mills-builds/agent-vision/docs/images/buslinker.png

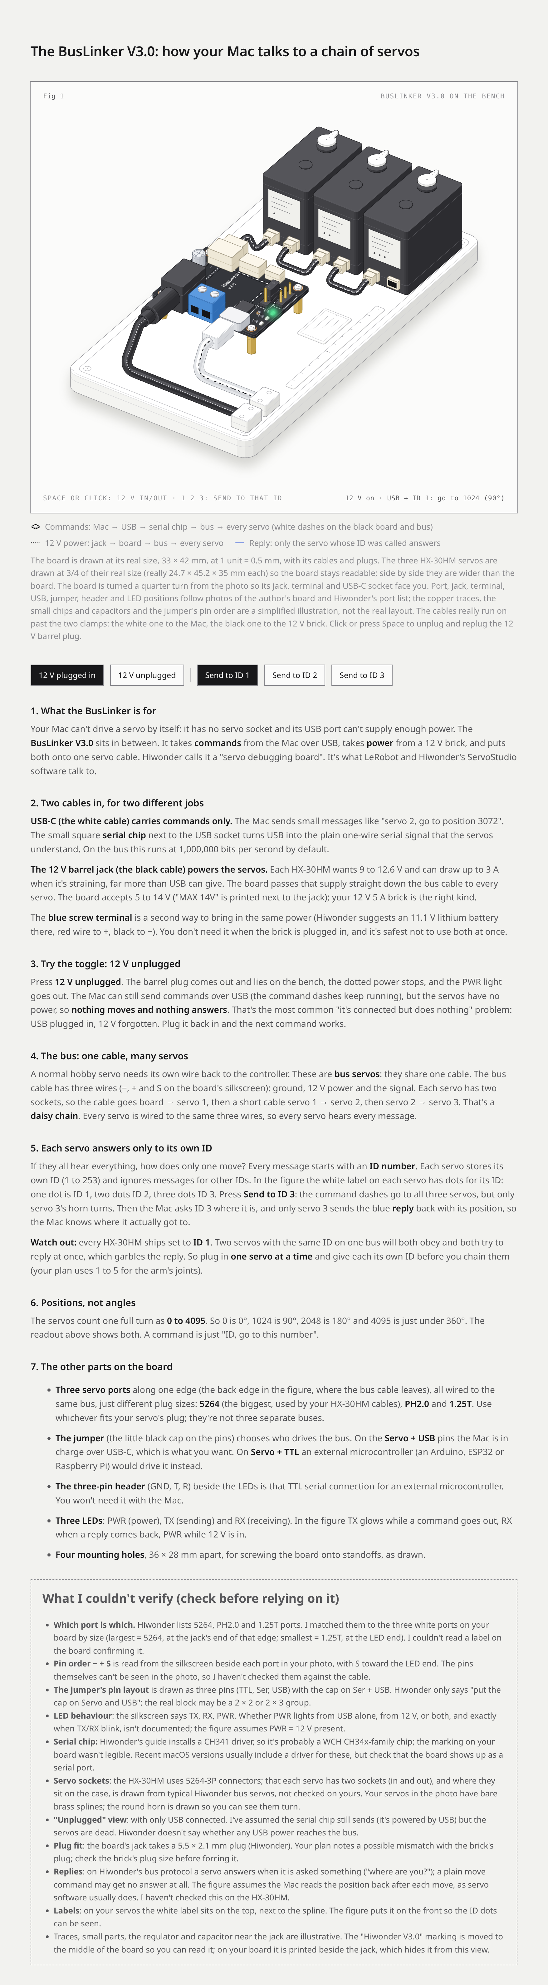
docs/images/buslinker.png
