mills-builds/agent-vision/docs/images/so101-camera-arm-dark.png

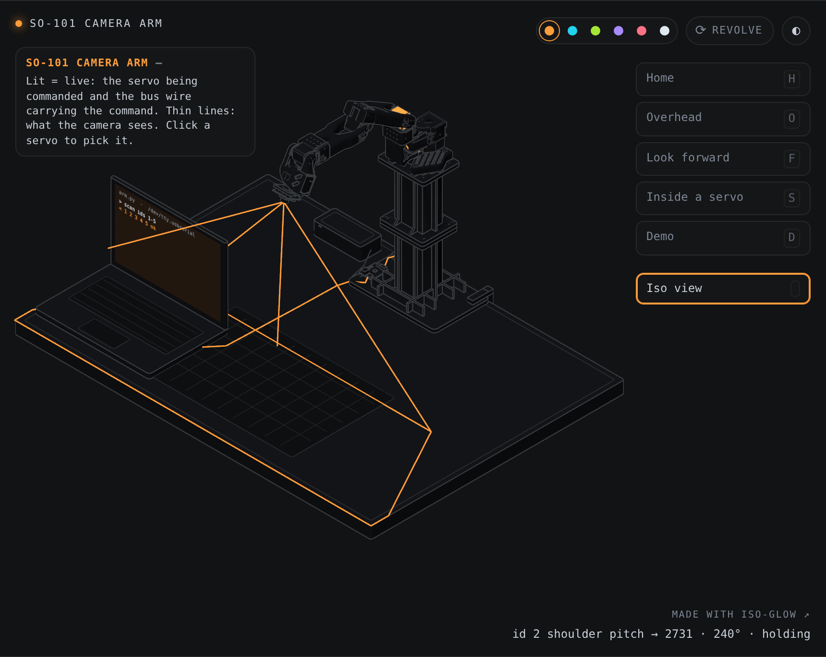
docs/images/so101-camera-arm-dark.png
