mills-builds/agent-vision/docs/images/so101-camera-arm-inside.png

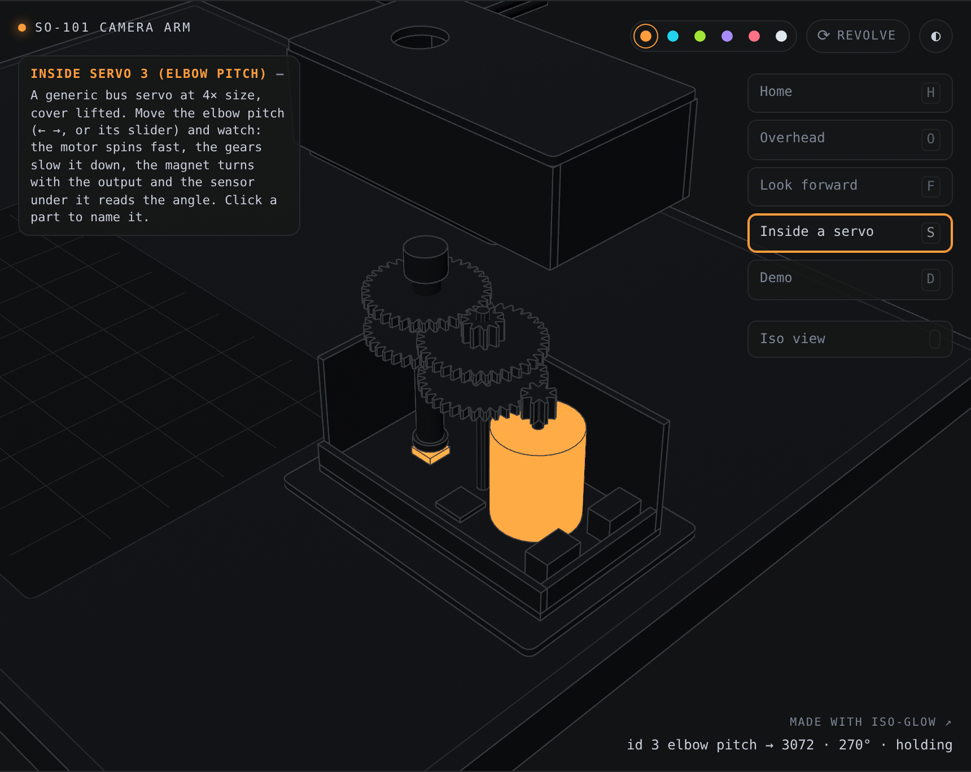
docs/images/so101-camera-arm-inside.png
