mills-builds/agent-vision/docs/images/so101-camera-arm-look.png

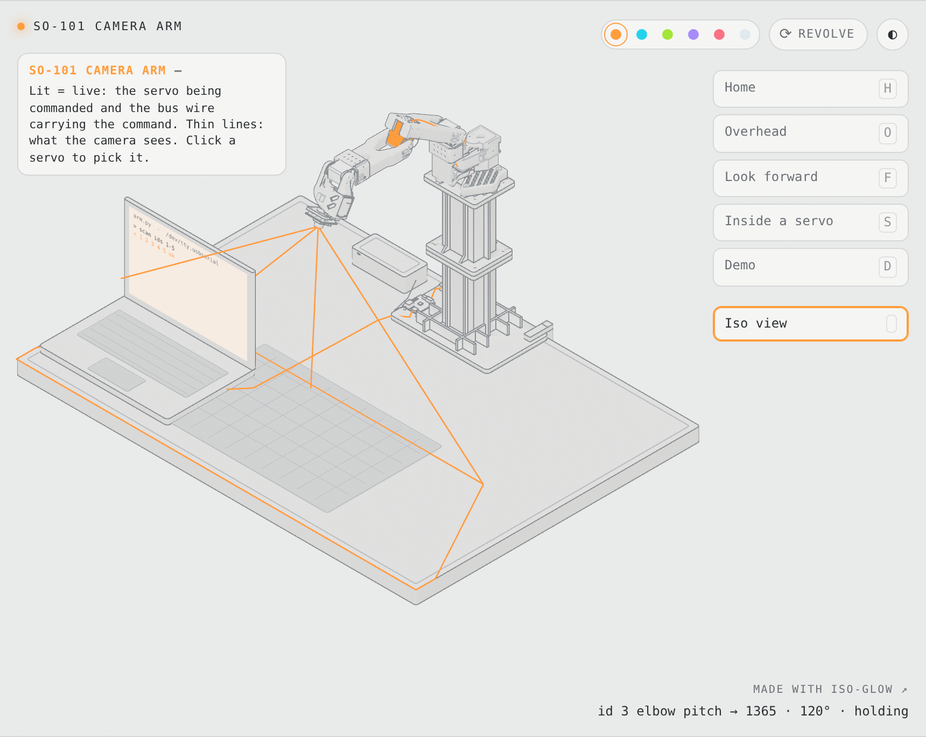
docs/images/so101-camera-arm-look.png
