mills-builds/agent-vision/cad/stl/arm_adapter_plate_v2_print-facedown.stl

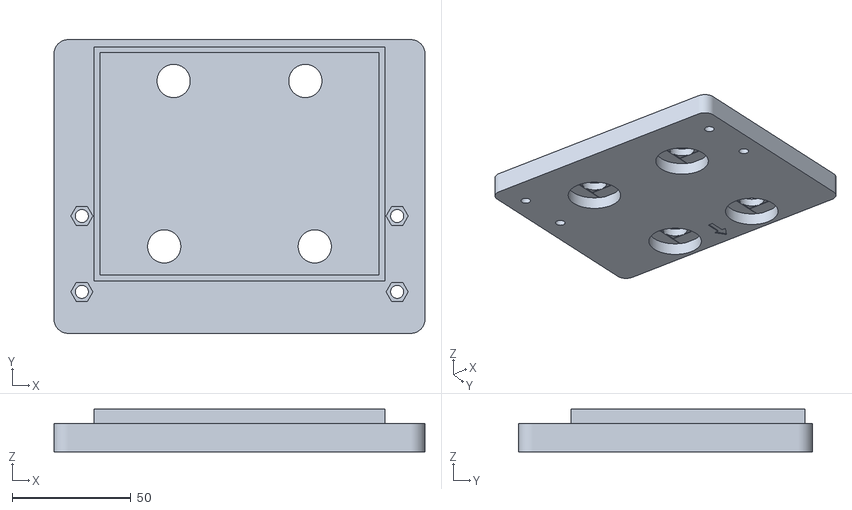
[picture p8: CAD file, 2026-10-14]
cad/stl/arm_adapter_plate_v2_print-facedown.stl
156.5 x 123.9 x 18.0
