mills-builds/agent-vision/cad/stl/arm_adapter_clamp_v2_left_print-facedown.stl

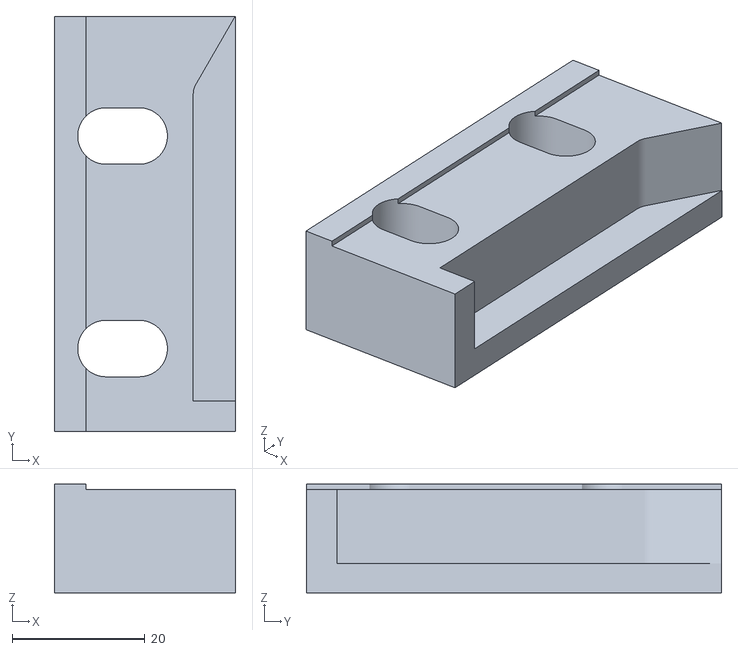
[picture p9: CAD file, 2026-10-14]
cad/stl/arm_adapter_clamp_v2_left_print-facedown.stl
27.2 x 62.5 x 16.4
