mills-builds/agent-vision/cad/stl/camera_plate_v3.stl

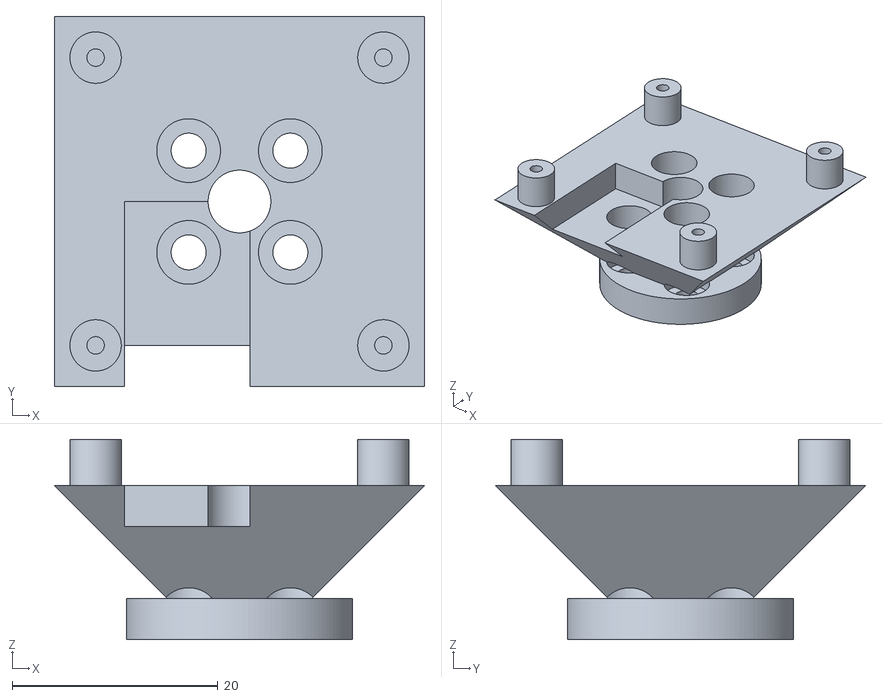
[picture p10: CAD file, 2026-10-14]
cad/stl/camera_plate_v3.stl
36.0 x 36.0 x 19.5
