mills-builds/agent-vision/cad/stl/riser_B_top_v2.stl

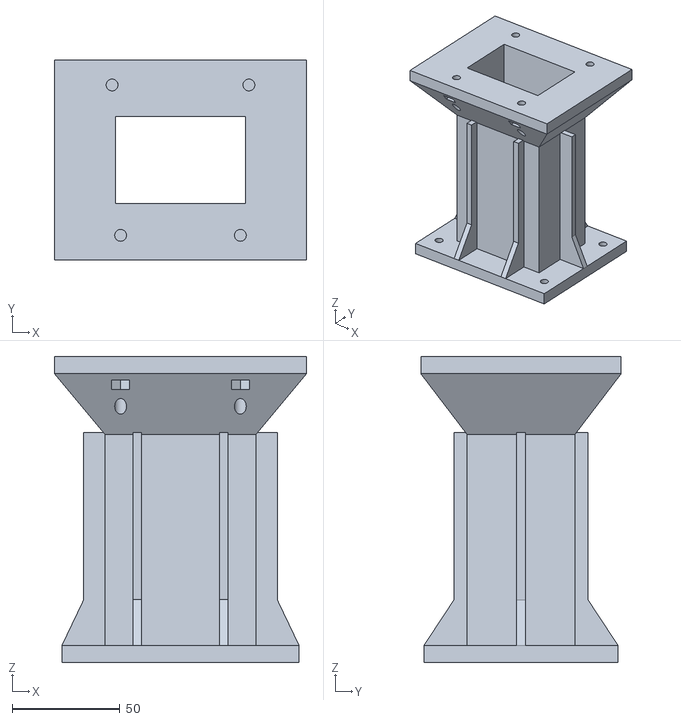
[picture p11: CAD file, 2026-10-14]
cad/stl/riser_B_top_v2.stl
117.0 x 93.0 x 142.0
