mills-builds/agent-vision/cad/stl/riser_A_foot_v2.stl

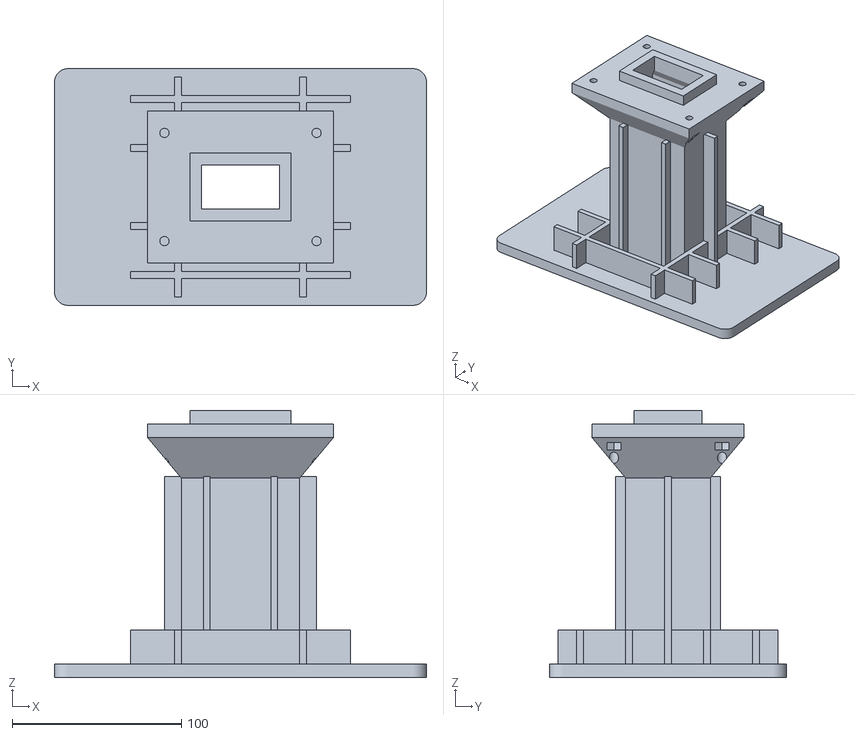
[picture p12: CAD file, 2026-10-14]
cad/stl/riser_A_foot_v2.stl
220.0 x 140.0 x 158.0
