mills-builds/agent-vision/cad/stl/buslinker_mount.stl

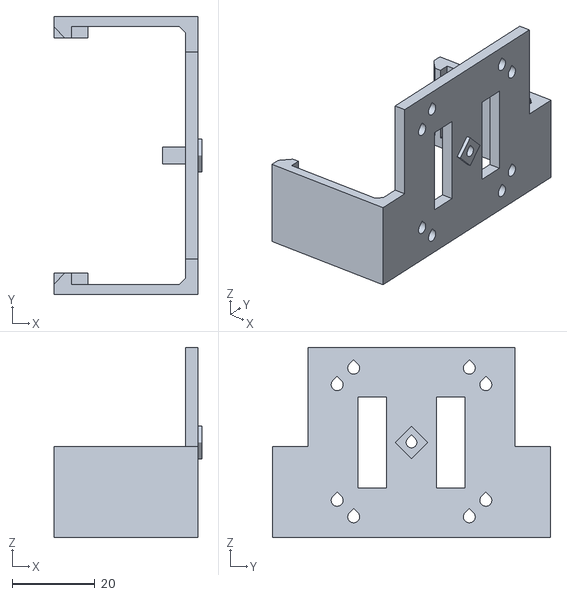
[picture p13: CAD file, 2026-10-14]
cad/stl/buslinker_mount.stl
35.8 x 67.4 x 46.0
