mills-builds/agent-vision/(list of files, cad)

Other CAD files:
cad/stl/arm_adapter_clamp_v2_right_print-facedown.stl
