mills-builds/agent-vision/(commit log)

2026-10-12 Agent Vision: riser and camera plate CAD, 3D explainers, credits
    [camera_plate.stl, riser_A_foot.stl, riser_B_top.stl]
2026-10-14 Move camera frames out of repo, ignore *.jpg, move assembly diagrams to docs/
2026-10-14 Add v2 arm adapter and BusLinker mount CAD sources
2026-10-14 Add agent_vision package: hx_bus driver and av_* tools with unit tests
2026-10-14 README: parts, assembly, wiring, setup, range discovery, presets, safety
2026-10-14 CAD: replace v1 riser/camera plate STLs with current v2 print files under cad/stl, add riser and camera plate sources
    [arm_adapter_clamp_v2_left_print-facedown.stl, arm_adapter_clamp_v2_right_print-facedown.stl, arm_adapter_plate_v2_print-facedown.stl, buslinker_mount.stl, camera_plate.stl, camera_plate_v3.stl, riser_A_foot.stl, riser_A_foot_v2.stl]
2026-10-14 Add HARDWARE.md bill of materials with fasteners per printed part
2026-10-14 README: link HARDWARE.md, point to cad/stl, update known gaps for v2 adapter and camera plate
2026-10-14 HARDWARE.md: all parts printed in white PLA
2026-10-14 HARDWARE.md: PicoBlade camera cable, riser joint tab-and-socket with CAD-derived M5 sizes
2026-10-14 Camera plate v3 rev c confirmed as printed; drop camera plate verify notes
2026-10-14 Explainer: show the v2 build (riser v2, adapter + clamps, BusLinker mount, camera plate v3 rev c); add GLB build tool
2026-10-22 Replace personal name with mills-builds handle
